cgz12345/pc_pwrbtn/(commit log)

2026-10-13 pc_pwrbtn: ESP32-S3 电脑远程开关机与状态感知系统 (开源安全脱敏发布版)
2026-10-13 feat: 固件启用下拉防悬空虚开机、Web App全面升级为SSD存储活动灯并增加交互式蓝牙配置指引
2026-10-13 fix: 彻底消除顶部遗留HDD字样改为SSD，修正未接灯线时误判已关机的状态逻辑
2026-10-13 docs: 完善最安全操作规程、详细电气逻辑与法律免责声明
2026-10-15 refactor: 将前面板4路引脚顺序平移优化为连续的 GPIO 4, 5, 6, 7
2026-10-15 fix: 采用 PLED- 低端驱动检测开机状态，状态图标改为显示屏防误认，称谓统一为硬盘
    [pc_pwrbtn.ino, secrets.example.h]
2026-10-15 fix: 兼容 disk_ago 键值并加入前端秒级平滑读写计时器
2026-10-15 feat: 增加电源键与复位键防误触确认弹窗，固件优化长按强关逻辑消除二次开机
2026-10-15 style: 调整主控按键排列顺序为关机/开机 -> 强关 -> 重启
2026-10-15 style: 彻底移除强关等按键的独立颜色标注，统一为纯色深灰磨砂玻璃风格
2026-10-15 style: 彻底重构高端深色钛金磨砂玻璃拟态UI，消灭全部红色边框，统一精致中性灰质感
2026-10-15 style: 找回经典翡翠绿呼吸光环、中央改为立式主机专属图标、彻底消灭强关红框并统一高级磨砂质感
2026-10-15 style: 升级为成套三色高质感磨砂玻璃按键体系（绿-电源 / 红-强关 / 橙-复位）
2026-10-16 fix(firmware): add disk_lit state mirror, 150ms debounce throttle, and update pin docs
    [pc_pwrbtn.ino]
2026-10-16 docs: add comprehensive hardware wiring diagram with 9-pin USB splitter and F_PANEL pinouts
2026-10-16 style(docs): redesign wiring diagram with zero-crossing horizontal parallel bus
2026-10-16 fix(firmware): calibrate disk LED debounce throttle to 200ms for solid-on mirroring
    [pc_pwrbtn.ino]
2026-10-16 feat(firmware): report pc_up host power-on duration for refresh-safe display
2026-10-18 fix(firmware): make PWR/RST pins fully passive (floating input) when idle, OD only during pulse
    [pc_pwrbtn.ino]
2026-10-18 docs: correct force-off description, document fully-passive idle pin state
2026-10-19 feat(firmware): self-healing (120s watchdog + TLS cleanup + 1s LED throttle) and three-mode WiFi auto-detect
2026-10-19 fix(firmware): disk LED windowed-activity mirror (1.2s window, 900ms report cap) for human-eye sync
    [pc_pwrbtn.ino]
2026-10-19 feat(firmware): disk LED change-report at 500ms floor (DISK_REPORT_MS) per user request
2026-10-23 docs: update wiring pinout to exact physical orientation (top row 4-pin key, bottom row 5-pin NC, RESET on pin 4)
